Skyhawkson/MIDI-Keyboard/Key Stem Reference Images/README.txt

I used the blue 8MM cherry dimensions, but added .125mm to each dimension for the socket.
