Skyhawkson/MIDI-Keyboard/Board Files/Mainboard.png

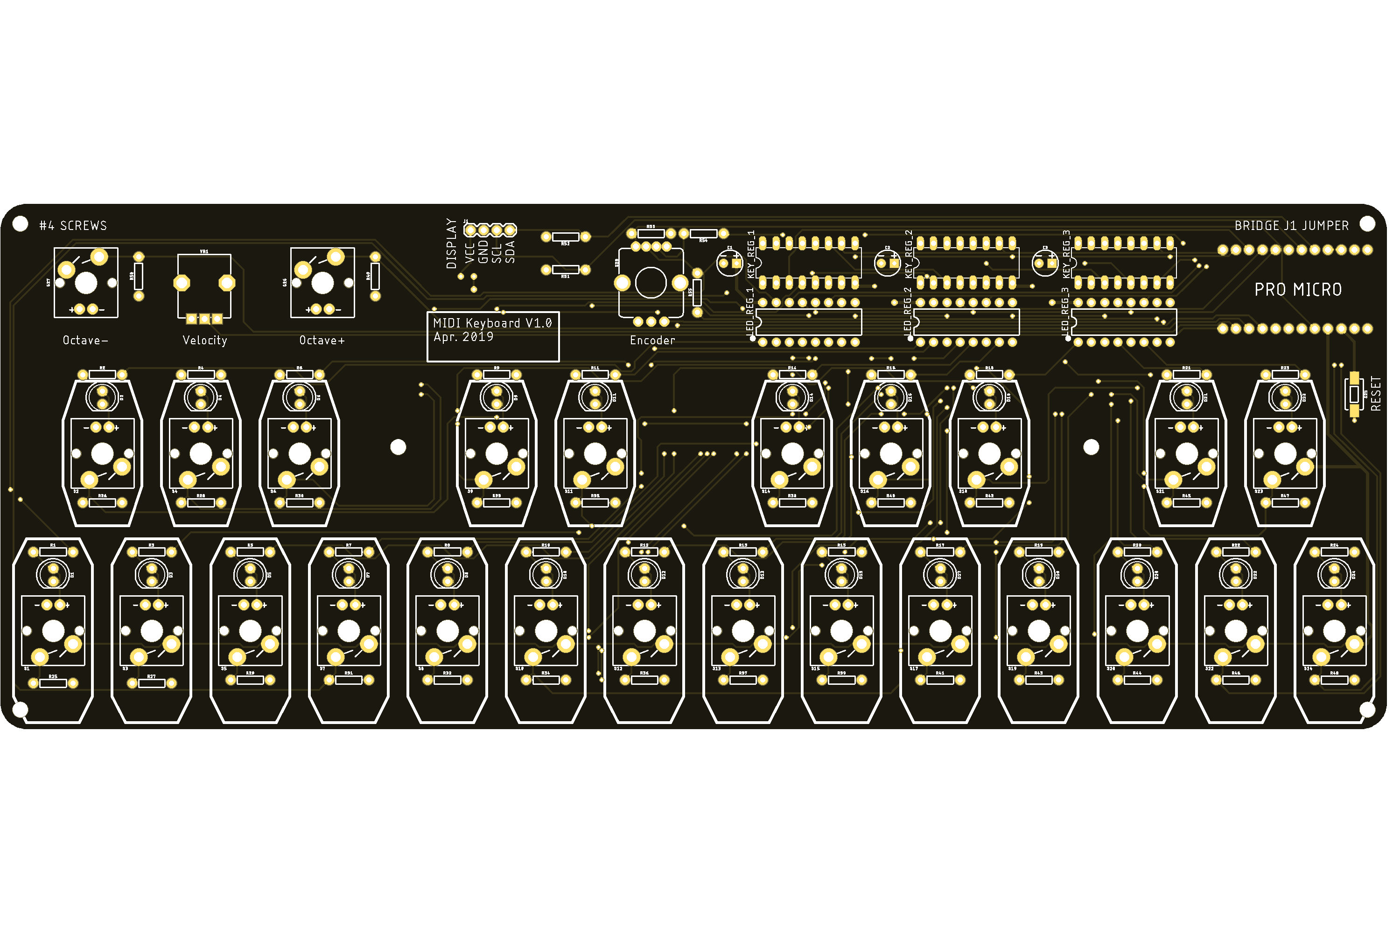
Board Files/Mainboard.png
