Skyhawkson/MIDI-Keyboard/Key Stem Reference Images/kailh-pg151101-cross-stem-specifications.jpg

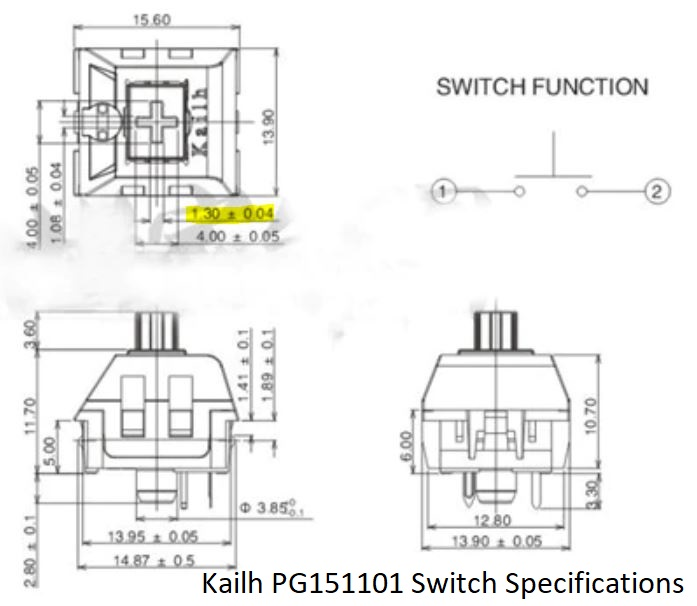
Key Stem Reference Images/kailh-pg151101-cross-stem-specifications.jpg
