Skyhawkson/MIDI-Keyboard/CAD Files/Board_Assembly.SLDASM

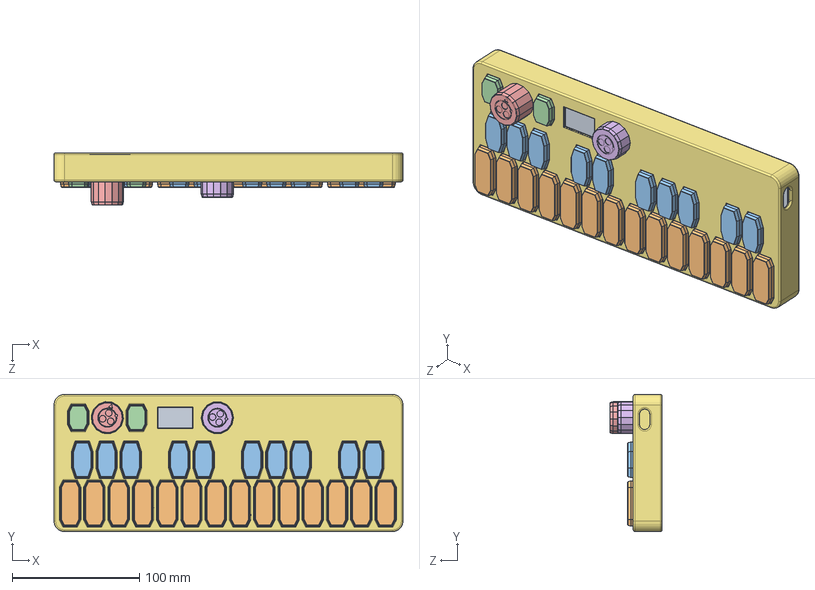
[picture p3: CAD file, 2019-04-23]
CAD Files/Board_Assembly.SLDASM
274.0 x 107.6 x 40.9 mm
White_Key_Flat x 14
Black_Key_Flat x 10
Octave_Key_Flat x 2
Velocity_Dial
Encoder_Dial
Top_Cover
Display
