Skyhawkson/MIDI-Keyboard/CAD Files/Mainboard_PCB.SLDPRT

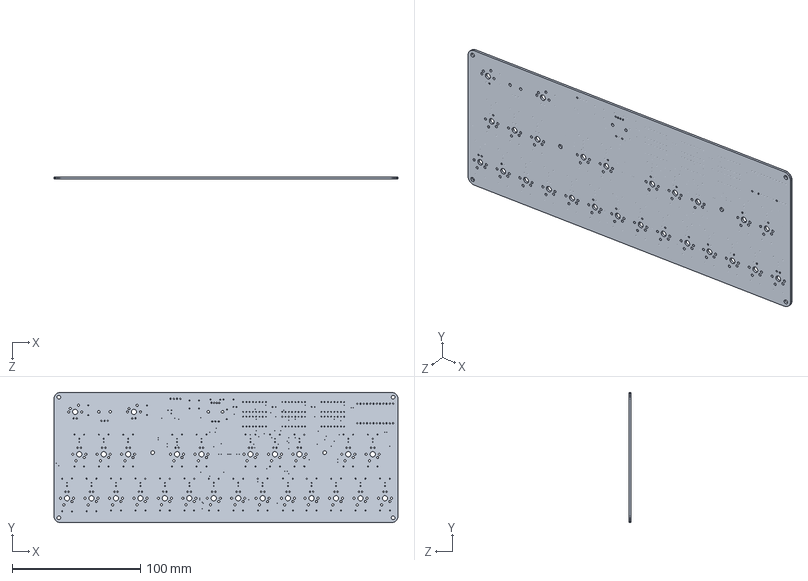
[picture p4: CAD file, 2019-04-22]
CAD Files/Mainboard_PCB.SLDPRT
268.0 x 101.6 x 1.60 mm
