Skyhawkson/MIDI-Keyboard/CAD Files/Top_Cover.SLDPRT

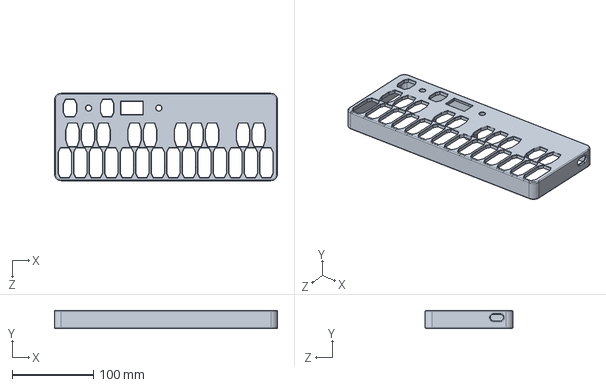
[picture p5: CAD file, 2019-04-23]
CAD Files/Top_Cover.SLDPRT
274.0 x 22.6 x 107.6 mm
