Skyhawkson/MIDI-Keyboard/CAD Files/Display.SLDPRT

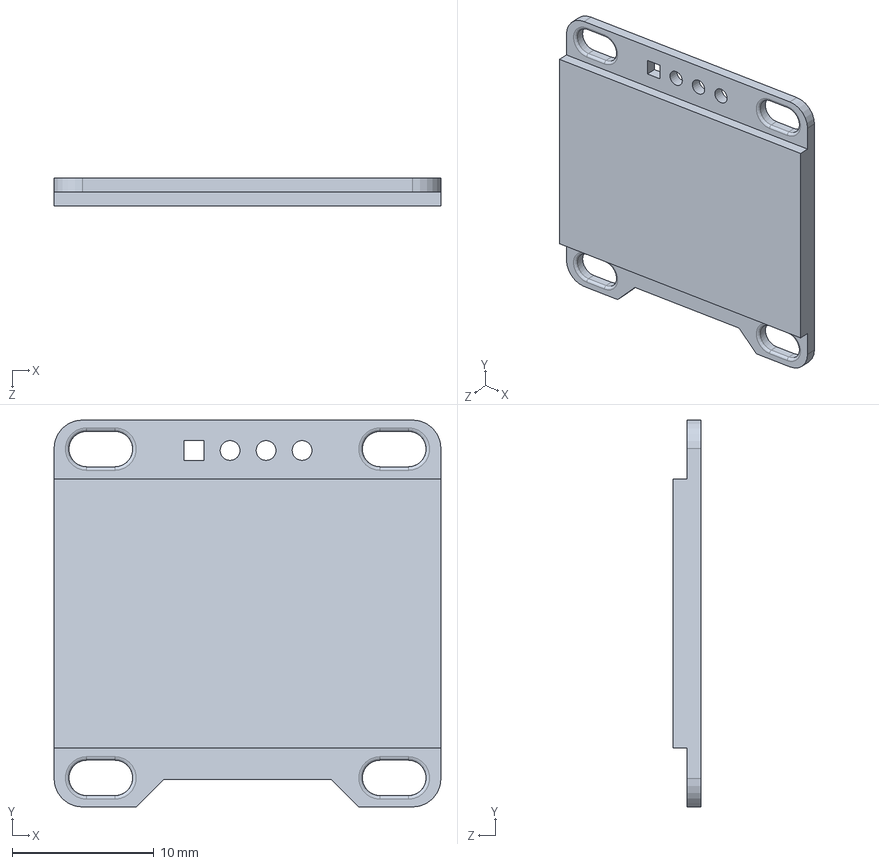
[picture p6: CAD file, 2019-04-23]
CAD Files/Display.SLDPRT
27.3 x 27.3 x 2.00 mm
