Skyhawkson/MIDI-Keyboard/CAD Files/White_Key_Flat.SLDPRT

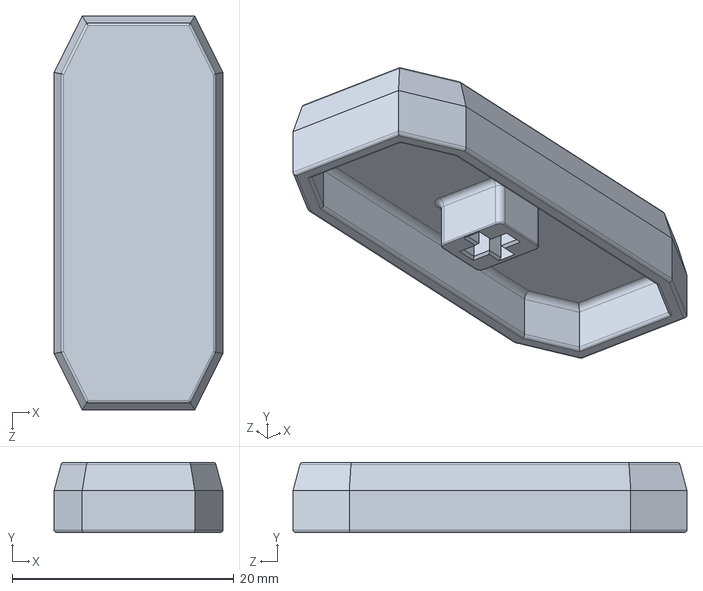
[picture p7: CAD file, 2019-04-23]
CAD Files/White_Key_Flat.SLDPRT
15.2 x 6.34 x 35.6 mm
