Skyhawkson/MIDI-Keyboard/CAD Files/Black_Key_Flat.SLDPRT

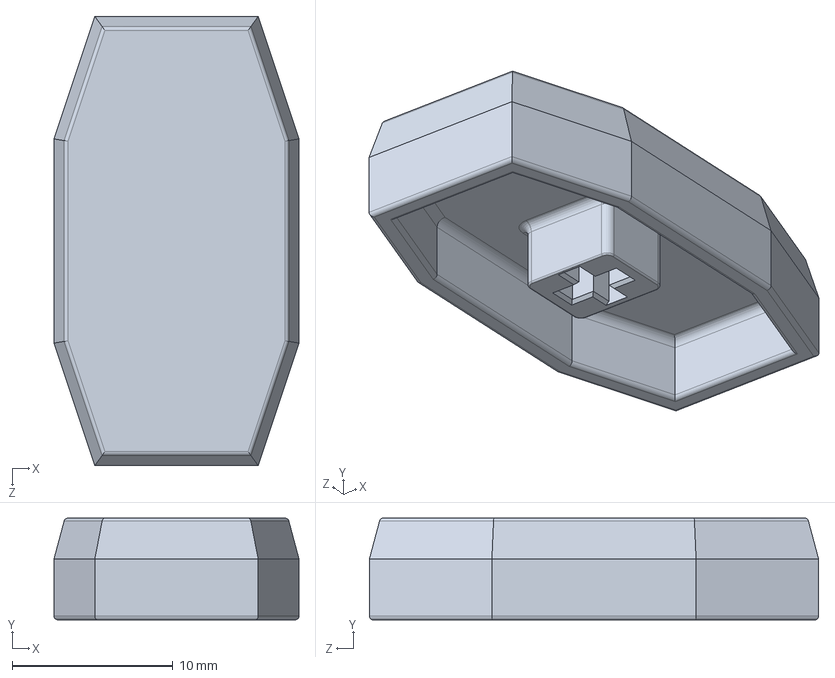
[picture p8: CAD file, 2019-04-23]
CAD Files/Black_Key_Flat.SLDPRT
15.2 x 6.34 x 27.9 mm
