Skyhawkson/MIDI-Keyboard/CAD Files/Bottom_Cover.SLDPRT

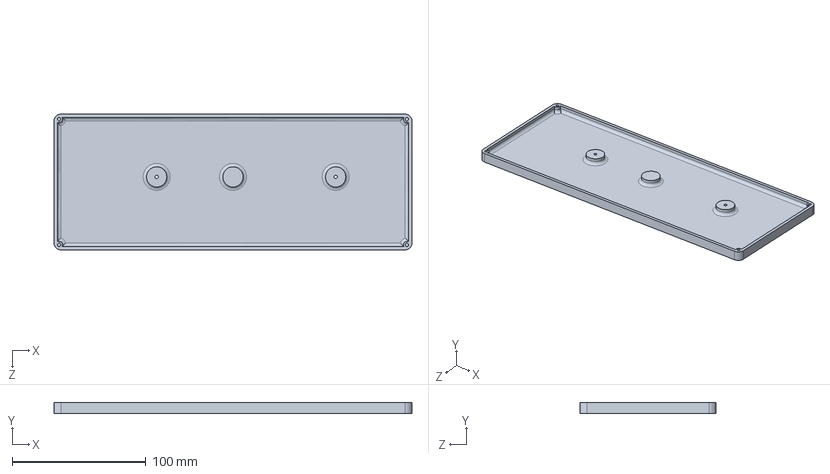
[picture p9: CAD file, 2019-04-23]
CAD Files/Bottom_Cover.SLDPRT
268.0 x 8.00 x 101.6 mm
