Skyhawkson/MIDI-Keyboard/CAD Files/Velocity_Dial.SLDPRT

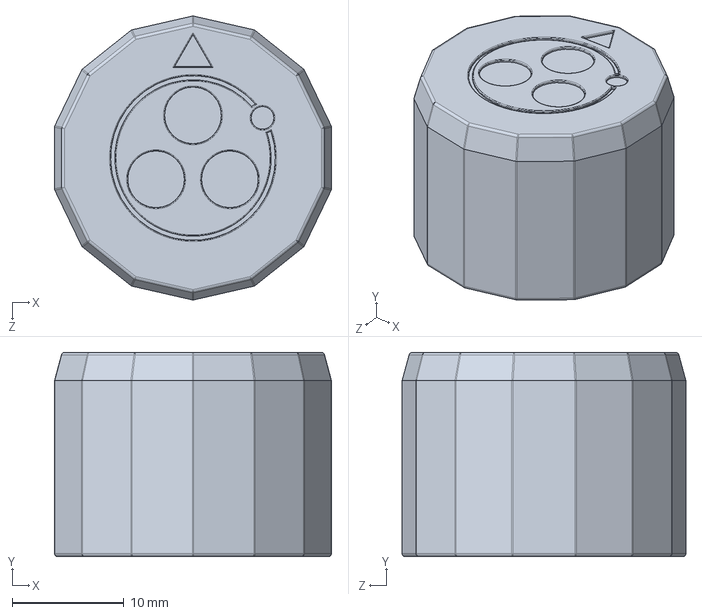
[picture p10: CAD file, 2019-04-23]
CAD Files/Velocity_Dial.SLDPRT
24.8 x 18.3 x 25.4 mm
