Skyhawkson/MIDI-Keyboard/CAD Files/Encoder_Dial.SLDPRT

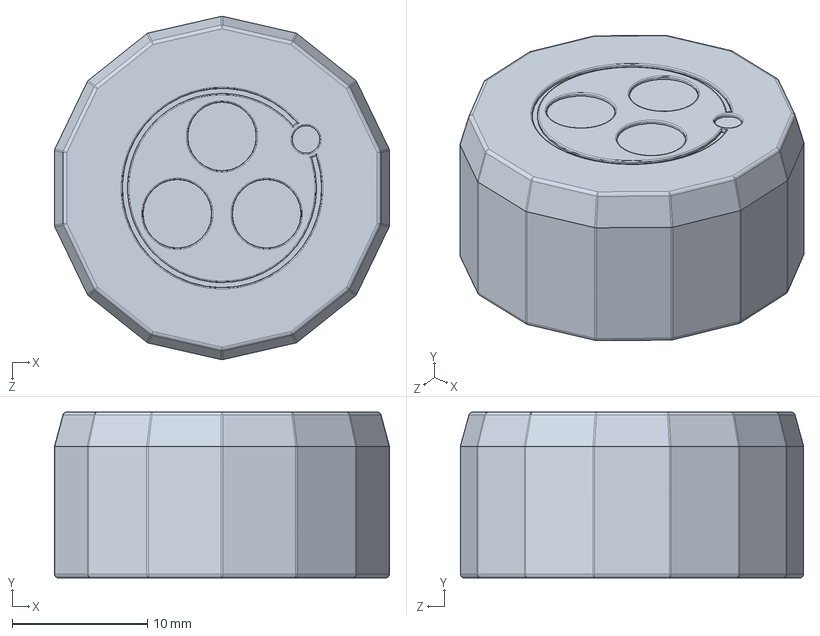
[picture p11: CAD file, 2019-04-23]
CAD Files/Encoder_Dial.SLDPRT
24.8 x 12.3 x 25.4 mm
