Skyhawkson/MIDI-Keyboard/CAD Files/Octave_Key_Flat.SLDPRT

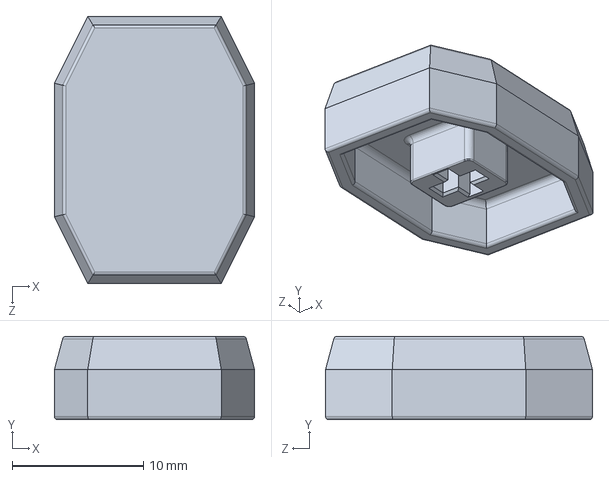
[picture p12: CAD file, 2019-04-23]
CAD Files/Octave_Key_Flat.SLDPRT
15.2 x 6.34 x 20.3 mm
