Skyhawkson/MIDI-Keyboard/(list of files, cad)

Other CAD files:
CAD Files/Encoder_Dial_V1.1.STL
CAD Files/Velocity_Dial_V1.1.STL
CAD Files/Octave_Key_Flat_V1.STL
CAD Files/White_Key_Dished.SLDPRT
CAD Files/Black_Key_Dished.SLDPRT
CAD Files/Black_Key_Flat_V1.STL
CAD Files/White_Key_Flat_V1.STL
CAD Files/Bottom_Cover.STL
CAD Files/Top_Cover.STL
