Skyhawkson/MIDI-Keyboard/(threads)

Thread 1 (2019-04-04):

LED Shift Register Master Reclear

Skyhawkson, 2019-04-04:
Consider assigning a Pro Micro pin to pin 10 of the 595's instead of just pulling them high, in order to allow for clearing of the register?

Skyhawkson, 2019-04-17:
-Nah. Pulling it high.

Closed 2019-04-17.

Thread 2 (2019-04-04):

Common Clock Pin?

Skyhawkson, 2019-04-04:
Determine whether a common clock pin is viable to free up an extra pin.

Skyhawkson, 2019-04-04:
On issue of common pins:
Data: Obviously not
Latch: No, since the LEDs aren't intended to update everytime the buttons aren't being read
Clock: Clock idles low for both, can share, as long as latch isn't common.

Closed 2019-04-04.
