Skyhawkson/MIDI-Keyboard/Board Files/Mainboard.brd

## EAGLE design Board Files/Mainboard.brd (2019-04-23)

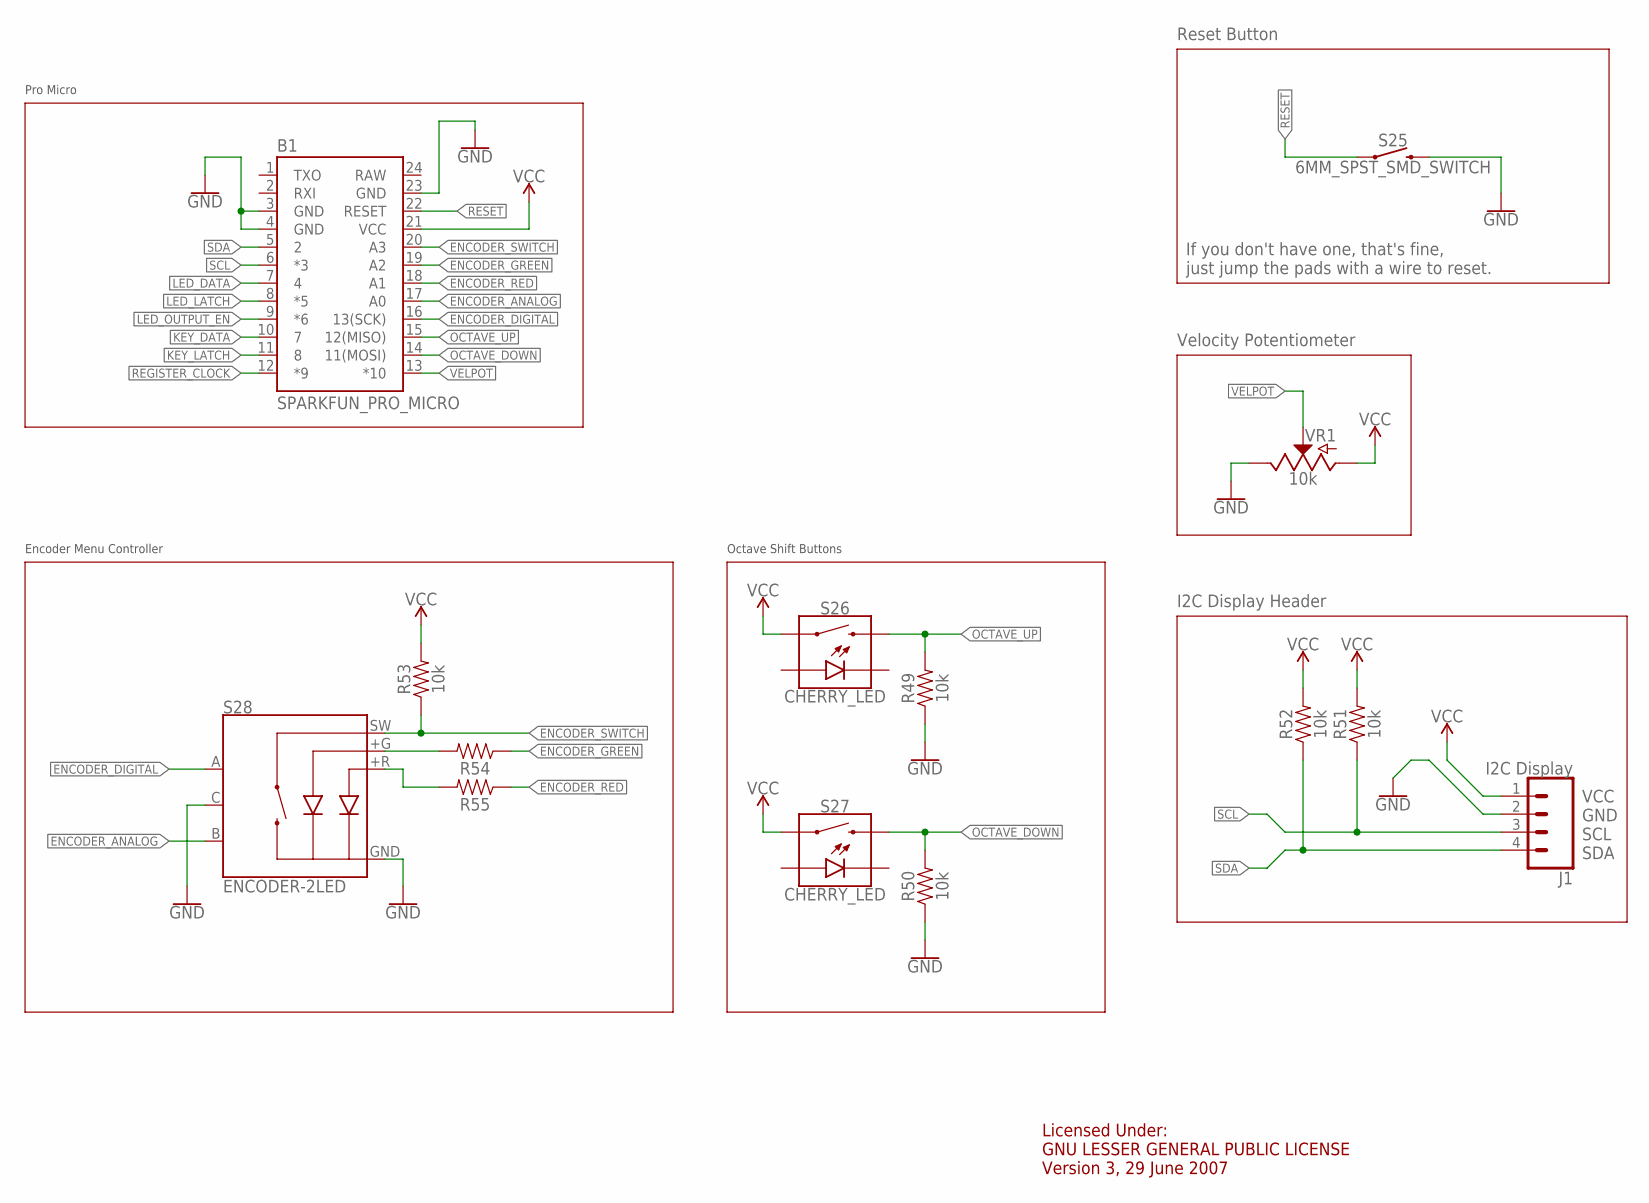
[picture p13: schematic Mainboard.sch, sheet 1, Pro Micro and Misc. IO]

Parts:
B1: SPARKFUN_PRO_MICRO
J1: I2C Display; 1X04
R49, R50, R51, R52, R53: 10k; AXIAL-0.3
R54, R55: AXIAL-0.3
S25: 6MM_SPST_SMD_SWITCH; TACTILE_SWITCH_SMD_6.0X3.5MM
S26, S27: CHERRY_LED; CHERRY-MX-LED
S28: ENCODER-2LED; ENCODER_LED_2
VR1: 10k; POT-PTH-ALPS

Connections:
ENCODER_ANALOG: B1.17 (A0), S28.B
ENCODER_DIGITAL: B1.16 (13(SCK)), S28.A
ENCODER_GREEN: B1.19 (A2), R54.P$1 (1)
ENCODER_RED: B1.18 (A1), R55.P$1 (1)
ENCODER_SWITCH: B1.20 (A3), R53.P$1 (1), S28.SW
GND: B1.3 (GND), B1.4 (GND), B1.23 (GND), J1.2, R49.P$1 (1), R50.P$1 (1), S25.2, S28.C, S28.GND (-), VR1.P$1 (E); also elsewhere on the board
KEY_DATA: B1.10 (7); also elsewhere on the board
KEY_LATCH: B1.11 (8); also elsewhere on the board
LED_DATA: B1.7 (4); also elsewhere on the board
LED_LATCH: B1.8 (*5); also elsewhere on the board
LED_OUTPUT_EN: B1.9 (*6); also elsewhere on the board
unnamed: R54.P$2 (2), S28.+G
unnamed: R55.P$2 (2), S28.+R
OCTAVE_DOWN: B1.14 (11(MOSI)), R50.P$2 (2), S27.S2 (2)
OCTAVE_UP: B1.15 (12(MISO)), R49.P$2 (2), S26.S2 (2)
RAW: B1.24 (RAW)
REGISTER_CLOCK: B1.12 (*9); also elsewhere on the board
RESET: B1.22 (RESET), S25.1
SCL: B1.6 (*3), J1.3, R51.P$1 (1)
SDA: B1.5 (2), J1.4, R52.P$1 (1)
VCC: B1.21 (VCC), J1.1, R51.P$2 (2), R52.P$2 (2), R53.P$2 (2), S26.S1 (1), S27.S1 (1), VR1.P$3 (A); also elsewhere on the board
VELPOT: B1.13 (*10), VR1.P$2 (S)

Notes on the sheet:
Reset Button
Velocity Potentiometer
VCC GND SCL SDA
I2C Display Header
If you don't have one, that's fine, just jump the pads with a wire to reset.
Licensed Under: GNU LESSER GENERAL PUBLIC LICENSE Version 3, 29 June 2007
Octave Shift Buttons
Encoder Menu Controller
Pro Micro

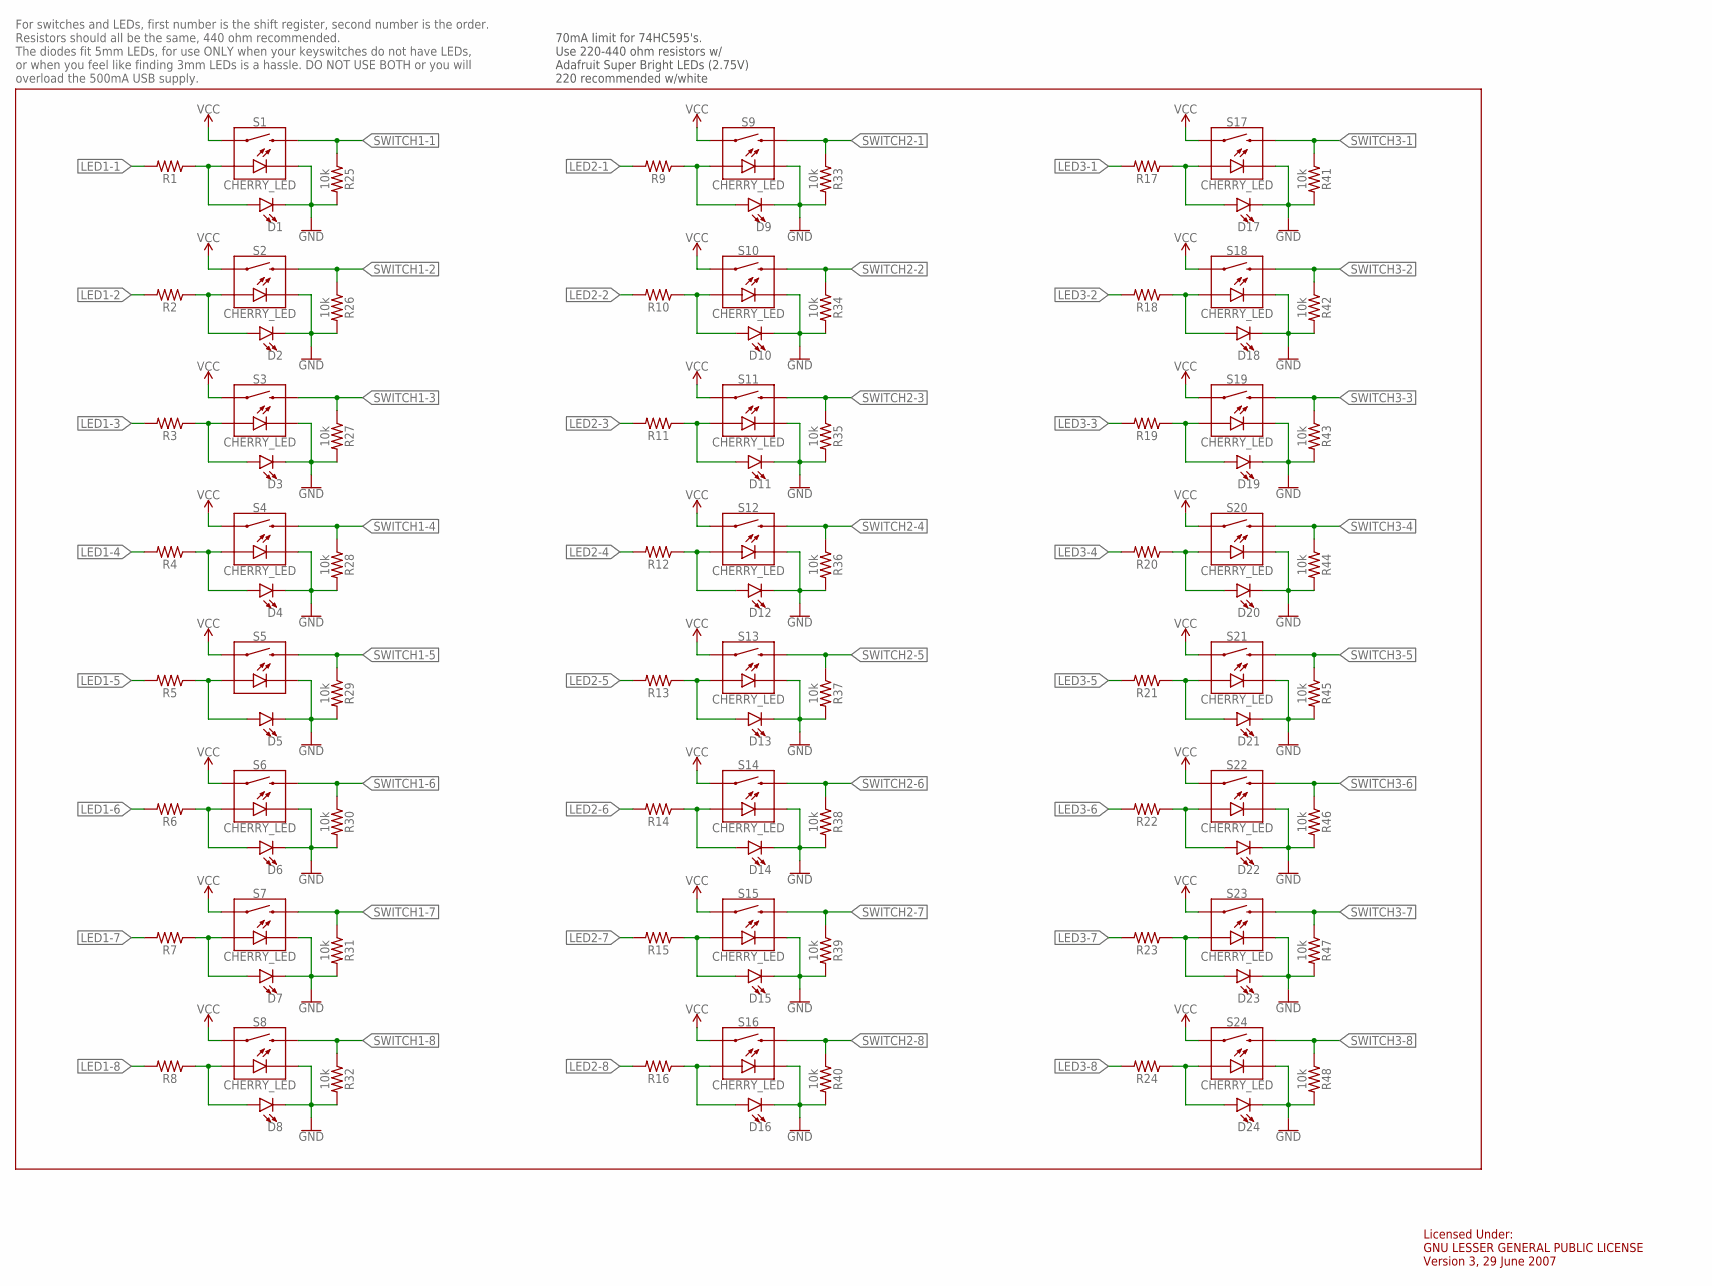
[picture p14: schematic Mainboard.sch, sheet 2, Keyswitches]

Parts:
D1, D2, D3, D4, D5, D6, D7, D8, D9, D10, D11, D12, D13, D14, D15, D16, D17, D18, D19, D20, D21, D22, D23, D24: LED5MM; LED_5MM
R1, R2, R3, R4, R5, R6, R7, R8, R9, R10, R11, R12, R13, R14, R15, R16, R17, R18, R19, R20, R21, R22, R23, R24: AXIAL-0.3
R25, R26, R27, R28, R29, R30, R31, R32, R33, R34, R35, R36, R37, R38, R39, R40, R41, R42, R43, R44, R45, R46, R47, R48: 10k; AXIAL-0.3
S1, S2, S3, S4, S6, S7, S8, S9, S10, S11, S12, S13, S14, S15, S16, S17, S18, S19, S20, S21, S22, S23, S24: CHERRY_LED; CHERRY-MX-LED
S5: MOMENTARY-SWITCH-SPST-LED-PTH-CHERRY; CHERRY-MX-LED

Connections:
GND: D1.K (C), D2.K (C), D3.K (C), D4.K (C), D5.K (C), D6.K (C), D7.K (C), D8.K (C), D9.K (C), D10.K (C), D11.K (C), D12.K (C), D13.K (C), D14.K (C), D15.K (C), D16.K (C), D17.K (C), D18.K (C), D19.K (C), D20.K (C), D21.K (C), D22.K (C), D23.K (C), D24.K (C), R25.P$2 (2), R26.P$2 (2), R27.P$2 (2), R28.P$2 (2), R29.P$2 (2), R30.P$2 (2), R31.P$2 (2), R32.P$2 (2), R33.P$2 (2), R34.P$2 (2), R35.P$2 (2), R36.P$2 (2), R37.P$2 (2), R38.P$2 (2), R39.P$2 (2), R40.P$2 (2), R41.P$2 (2), R42.P$2 (2), R43.P$2 (2), R44.P$2 (2), R45.P$2 (2), R46.P$2 (2), R47.P$2 (2), R48.P$2 (2), S1.K (C), S2.K (C), S3.K (C), S4.K (C), S5.K (C), S6.K (C), S7.K (C), S8.K (C), S9.K (C), S10.K (C), S11.K (C), S12.K (C), S13.K (C), S14.K (C), S15.K (C), S16.K (C), S17.K (C), S18.K (C), S19.K (C), S20.K (C), S21.K (C), S22.K (C), S23.K (C), S24.K (C); also elsewhere on the board
LED1-1: R1.P$2 (2); also elsewhere on the board
LED1-2: R2.P$2 (2); also elsewhere on the board
LED1-3: R3.P$2 (2); also elsewhere on the board
LED1-4: R4.P$2 (2); also elsewhere on the board
LED1-5: R5.P$2 (2); also elsewhere on the board
LED1-6: R6.P$2 (2); also elsewhere on the board
LED1-7: R7.P$2 (2); also elsewhere on the board
LED1-8: R8.P$2 (2); also elsewhere on the board
LED2-1: R9.P$2 (2); also elsewhere on the board
LED2-2: R10.P$2 (2); also elsewhere on the board
LED2-3: R11.P$2 (2); also elsewhere on the board
LED2-4: R12.P$2 (2); also elsewhere on the board
LED2-5: R13.P$2 (2); also elsewhere on the board
LED2-6: R14.P$2 (2); also elsewhere on the board
LED2-7: R15.P$2 (2); also elsewhere on the board
LED2-8: R16.P$2 (2); also elsewhere on the board
LED3-1: R17.P$2 (2); also elsewhere on the board
LED3-2: R18.P$2 (2); also elsewhere on the board
LED3-3: R19.P$2 (2); also elsewhere on the board
LED3-4: R20.P$2 (2); also elsewhere on the board
LED3-5: R21.P$2 (2); also elsewhere on the board
LED3-6: R22.P$2 (2); also elsewhere on the board
LED3-7: R23.P$2 (2); also elsewhere on the board
LED3-8: R24.P$2 (2); also elsewhere on the board
unnamed: D1.A, R1.P$1 (1), S1.A
unnamed: D2.A, R2.P$1 (1), S2.A
unnamed: D3.A, R3.P$1 (1), S3.A
unnamed: D4.A, R4.P$1 (1), S4.A
unnamed: D5.A, R5.P$1 (1), S5.A
unnamed: D6.A, R6.P$1 (1), S6.A
unnamed: D7.A, R7.P$1 (1), S7.A
unnamed: D8.A, R8.P$1 (1), S8.A
unnamed: D9.A, R9.P$1 (1), S9.A
unnamed: D10.A, R10.P$1 (1), S10.A
unnamed: D11.A, R11.P$1 (1), S11.A
unnamed: D12.A, R12.P$1 (1), S12.A
unnamed: D13.A, R13.P$1 (1), S13.A
unnamed: D14.A, R14.P$1 (1), S14.A
unnamed: D15.A, R15.P$1 (1), S15.A
unnamed: D16.A, R16.P$1 (1), S16.A
unnamed: D17.A, R17.P$1 (1), S17.A
unnamed: D18.A, R18.P$1 (1), S18.A
unnamed: D19.A, R19.P$1 (1), S19.A
unnamed: D20.A, R20.P$1 (1), S20.A
unnamed: D21.A, R21.P$1 (1), S21.A
unnamed: D22.A, R22.P$1 (1), S22.A
unnamed: D23.A, R23.P$1 (1), S23.A
unnamed: D24.A, R24.P$1 (1), S24.A
SWITCH1-1: R25.P$1 (1), S1.S2 (2); also elsewhere on the board
SWITCH1-2: R26.P$1 (1), S2.S2 (2); also elsewhere on the board
SWITCH1-3: R27.P$1 (1), S3.S2 (2); also elsewhere on the board
SWITCH1-4: R28.P$1 (1), S4.S2 (2); also elsewhere on the board
SWITCH1-5: R29.P$1 (1), S5.S2 (2); also elsewhere on the board
SWITCH1-6: R30.P$1 (1), S6.S2 (2); also elsewhere on the board
SWITCH1-7: R31.P$1 (1), S7.S2 (2); also elsewhere on the board
SWITCH1-8: R32.P$1 (1), S8.S2 (2); also elsewhere on the board
SWITCH2-1: R33.P$1 (1), S9.S2 (2); also elsewhere on the board
SWITCH2-2: R34.P$1 (1), S10.S2 (2); also elsewhere on the board
SWITCH2-3: R35.P$1 (1), S11.S2 (2); also elsewhere on the board
SWITCH2-4: R36.P$1 (1), S12.S2 (2); also elsewhere on the board
SWITCH2-5: R37.P$1 (1), S13.S2 (2); also elsewhere on the board
SWITCH2-6: R38.P$1 (1), S14.S2 (2); also elsewhere on the board
SWITCH2-7: R39.P$1 (1), S15.S2 (2); also elsewhere on the board
SWITCH2-8: R40.P$1 (1), S16.S2 (2); also elsewhere on the board
SWITCH3-1: R41.P$1 (1), S17.S2 (2); also elsewhere on the board
SWITCH3-2: R42.P$1 (1), S18.S2 (2); also elsewhere on the board
SWITCH3-3: R43.P$1 (1), S19.S2 (2); also elsewhere on the board
SWITCH3-4: R44.P$1 (1), S20.S2 (2); also elsewhere on the board
SWITCH3-5: R45.P$1 (1), S21.S2 (2); also elsewhere on the board
SWITCH3-6: R46.P$1 (1), S22.S2 (2); also elsewhere on the board
SWITCH3-7: R47.P$1 (1), S23.S2 (2); also elsewhere on the board
SWITCH3-8: R48.P$1 (1), S24.S2 (2); also elsewhere on the board
VCC: S1.S1 (1), S2.S1 (1), S3.S1 (1), S4.S1 (1), S5.S1 (1), S6.S1 (1), S7.S1 (1), S8.S1 (1), S9.S1 (1), S10.S1 (1), S11.S1 (1), S12.S1 (1), S13.S1 (1), S14.S1 (1), S15.S1 (1), S16.S1 (1), S17.S1 (1), S18.S1 (1), S19.S1 (1), S20.S1 (1), S21.S1 (1), S22.S1 (1), S23.S1 (1), S24.S1 (1); also elsewhere on the board

Notes on the sheet:
For switches and LEDs, first number is the shift register, second number is the order. Resistors should all be the same, 440 ohm recommended. The diodes fit 5mm LEDs, for use ONLY when your keyswitches do not have LEDs, or when you feel like finding 3mm LEDs is a hassle. DO NOT USE BOTH or you will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
70mA limit for 74HC595's. Use 220-440 ohm resistors w/ Adafruit Super Bright LEDs (2.75V) 220 recommended w/white
Licensed Under: GNU LESSER GENERAL PUBLIC LICENSE Version 3, 29 June 2007

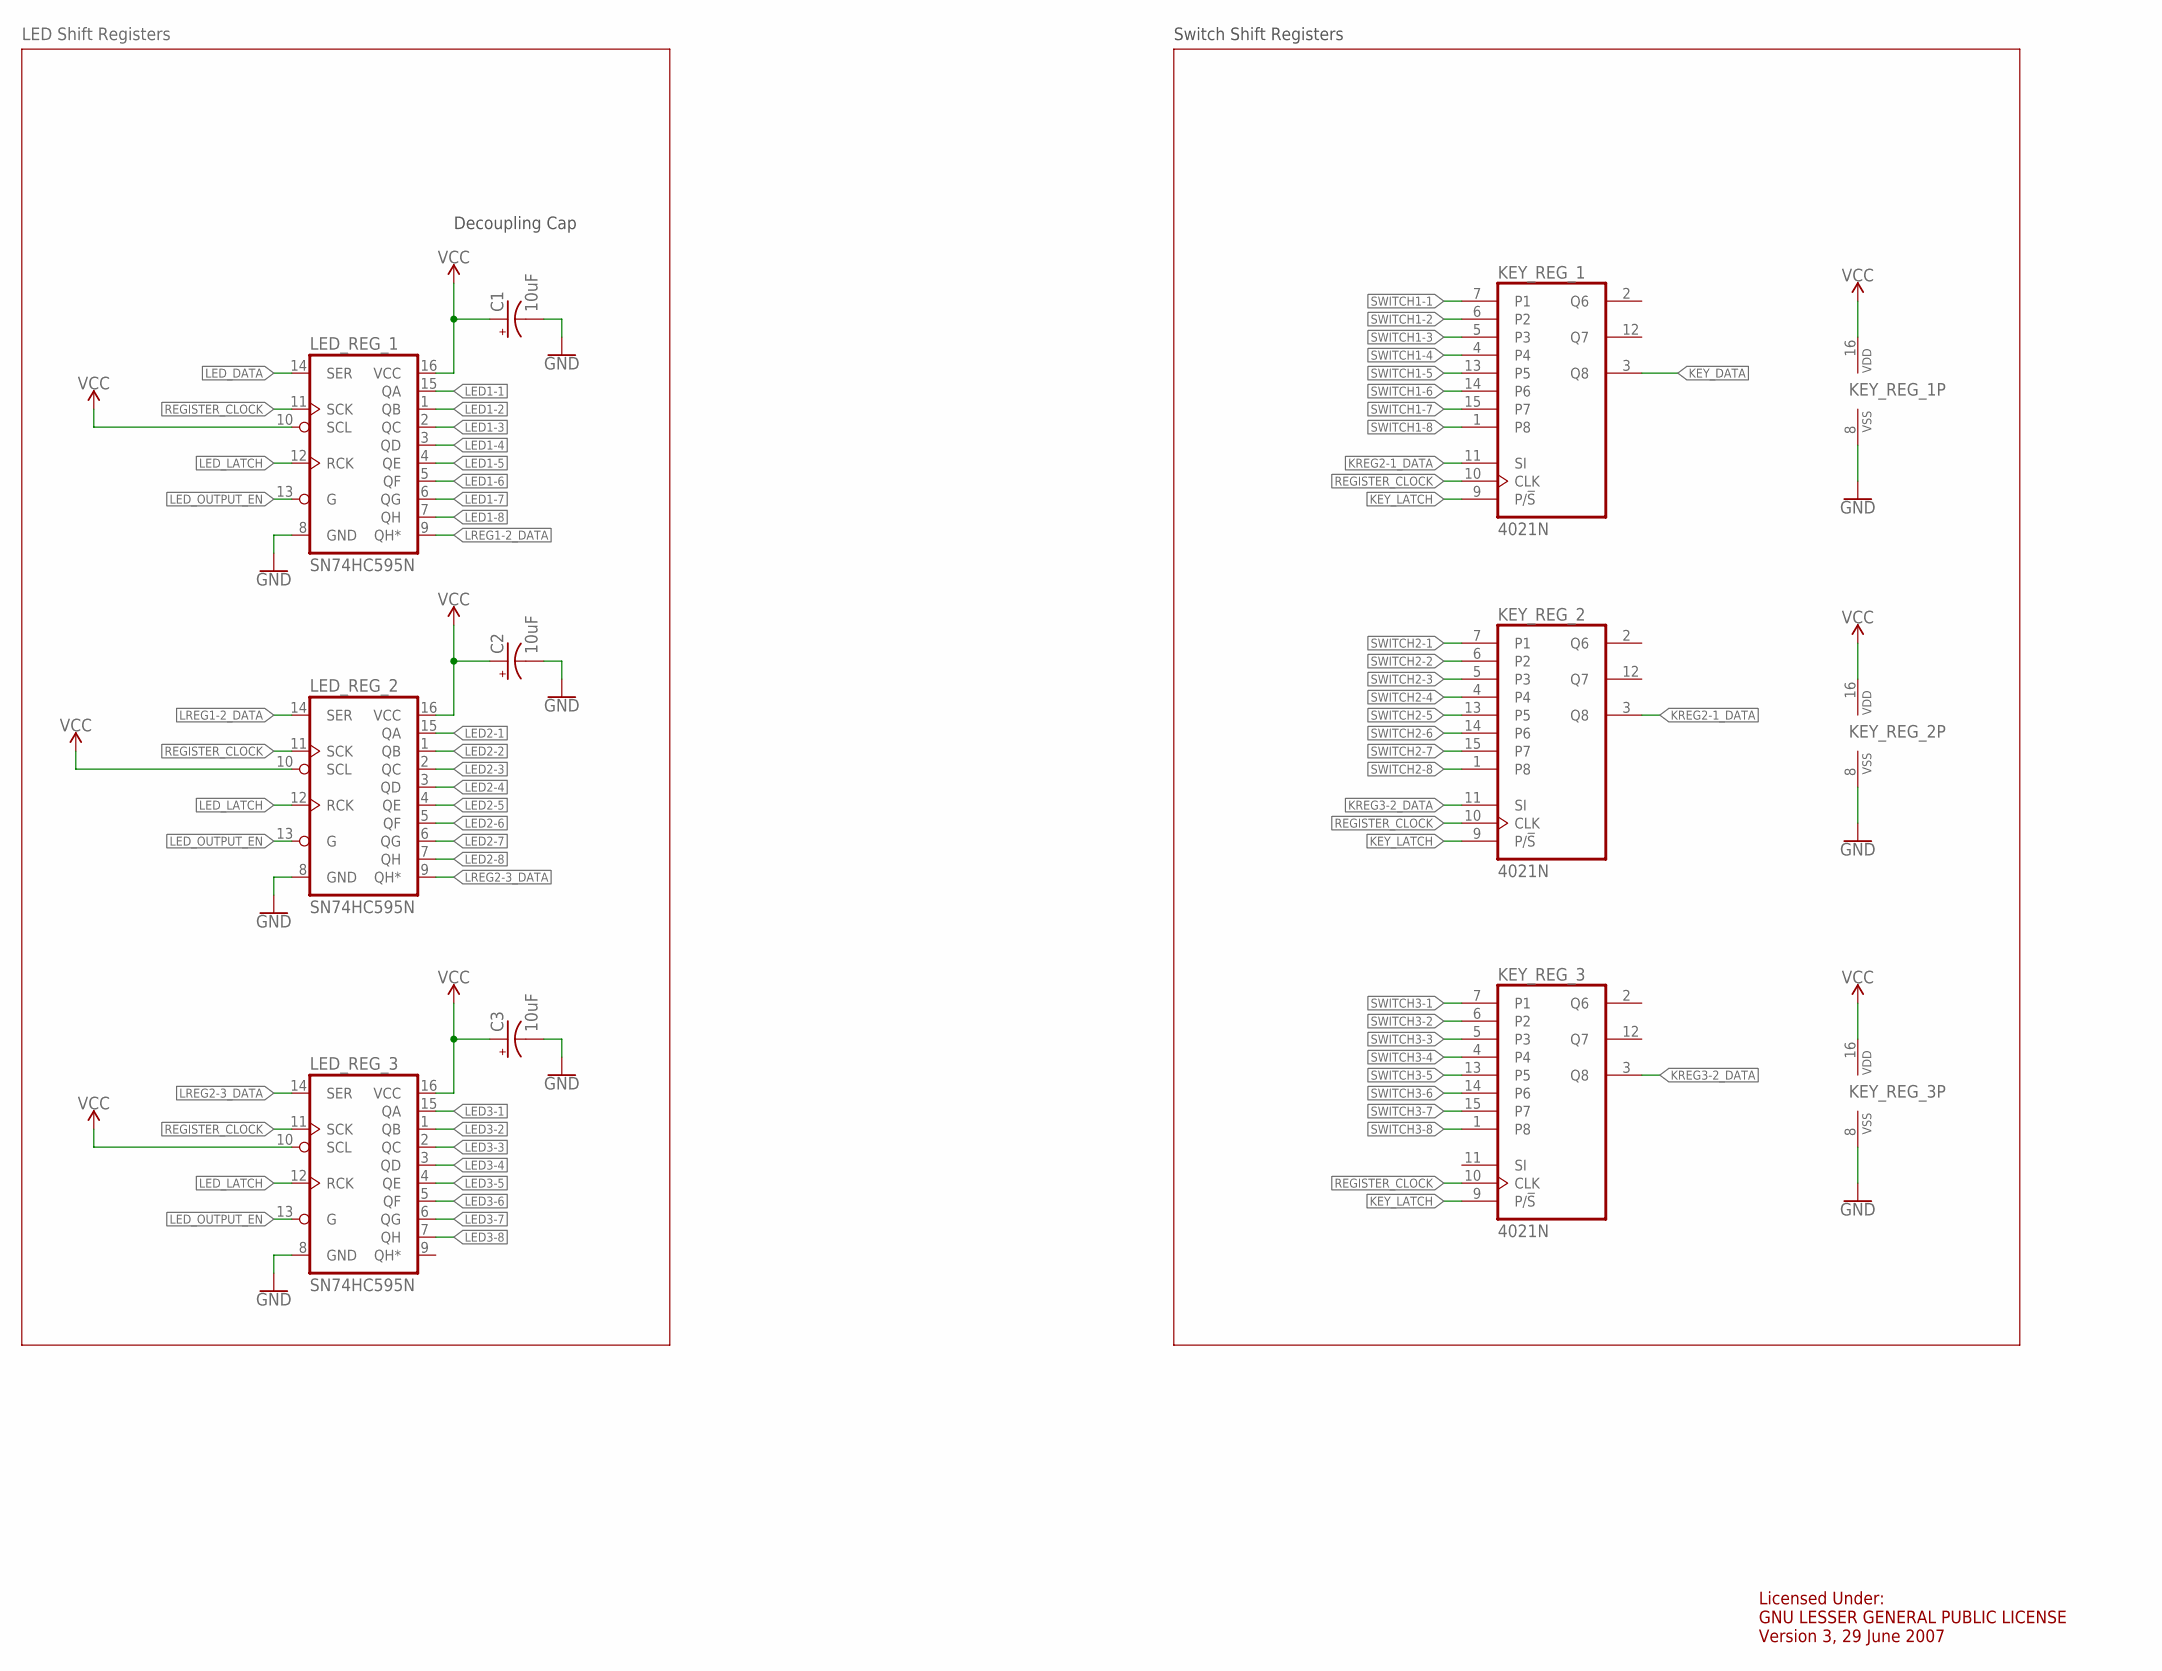
[picture p15: schematic Mainboard.sch, sheet 3, Shift Registers]

Parts:
C1, C2, C3: 10uF; CPOL-RADIAL-2.5MM-5MM
KEY_REG_1, KEY_REG_2, KEY_REG_3: 4021N; DIL16
LED_REG_1, LED_REG_2, LED_REG_3: SN74HC595N; DIP16

Connections:
GND: C1.2 (-), C2.2 (-), C3.2 (-), KEY_REG_1.8 (VSS), KEY_REG_2.8 (VSS), KEY_REG_3.8 (VSS), LED_REG_1.8 (GND), LED_REG_2.8 (GND), LED_REG_3.8 (GND); also elsewhere on the board
KEY_DATA: KEY_REG_1.3 (Q8); also elsewhere on the board
KEY_LATCH: KEY_REG_1.9 (P/!S), KEY_REG_2.9 (P/!S), KEY_REG_3.9 (P/!S); also elsewhere on the board
KREG2-1_DATA: KEY_REG_1.11 (SI), KEY_REG_2.3 (Q8)
KREG3-2_DATA: KEY_REG_2.11 (SI), KEY_REG_3.3 (Q8)
LED1-1: LED_REG_1.15 (QA); also elsewhere on the board
LED1-2: LED_REG_1.1 (QB); also elsewhere on the board
LED1-3: LED_REG_1.2 (QC); also elsewhere on the board
LED1-4: LED_REG_1.3 (QD); also elsewhere on the board
LED1-5: LED_REG_1.4 (QE); also elsewhere on the board
LED1-6: LED_REG_1.5 (QF); also elsewhere on the board
LED1-7: LED_REG_1.6 (QG); also elsewhere on the board
LED1-8: LED_REG_1.7 (QH); also elsewhere on the board
LED2-1: LED_REG_2.15 (QA); also elsewhere on the board
LED2-2: LED_REG_2.1 (QB); also elsewhere on the board
LED2-3: LED_REG_2.2 (QC); also elsewhere on the board
LED2-4: LED_REG_2.3 (QD); also elsewhere on the board
LED2-5: LED_REG_2.4 (QE); also elsewhere on the board
LED2-6: LED_REG_2.5 (QF); also elsewhere on the board
LED2-7: LED_REG_2.6 (QG); also elsewhere on the board
LED2-8: LED_REG_2.7 (QH); also elsewhere on the board
LED3-1: LED_REG_3.15 (QA); also elsewhere on the board
LED3-2: LED_REG_3.1 (QB); also elsewhere on the board
LED3-3: LED_REG_3.2 (QC); also elsewhere on the board
LED3-4: LED_REG_3.3 (QD); also elsewhere on the board
LED3-5: LED_REG_3.4 (QE); also elsewhere on the board
LED3-6: LED_REG_3.5 (QF); also elsewhere on the board
LED3-7: LED_REG_3.6 (QG); also elsewhere on the board
LED3-8: LED_REG_3.7 (QH); also elsewhere on the board
LED_DATA: LED_REG_1.14 (SER); also elsewhere on the board
LED_LATCH: LED_REG_1.12 (RCK), LED_REG_2.12 (RCK), LED_REG_3.12 (RCK); also elsewhere on the board
LED_OUTPUT_EN: LED_REG_1.13 (G), LED_REG_2.13 (G), LED_REG_3.13 (G); also elsewhere on the board
LREG1-2_DATA: LED_REG_1.9 (QH*), LED_REG_2.14 (SER)
LREG2-3_DATA: LED_REG_2.9 (QH*), LED_REG_3.14 (SER)
REGISTER_CLOCK: KEY_REG_1.10 (CLK), KEY_REG_2.10 (CLK), KEY_REG_3.10 (CLK), LED_REG_1.11 (SCK), LED_REG_2.11 (SCK), LED_REG_3.11 (SCK); also elsewhere on the board
SWITCH1-1: KEY_REG_1.7 (P1); also elsewhere on the board
SWITCH1-2: KEY_REG_1.6 (P2); also elsewhere on the board
SWITCH1-3: KEY_REG_1.5 (P3); also elsewhere on the board
SWITCH1-4: KEY_REG_1.4; also elsewhere on the board
SWITCH1-5: KEY_REG_1.13 (P5); also elsewhere on the board
SWITCH1-6: KEY_REG_1.14 (P6); also elsewhere on the board
SWITCH1-7: KEY_REG_1.15 (P7); also elsewhere on the board
SWITCH1-8: KEY_REG_1.1 (P8); also elsewhere on the board
SWITCH2-1: KEY_REG_2.7 (P1); also elsewhere on the board
SWITCH2-2: KEY_REG_2.6 (P2); also elsewhere on the board
SWITCH2-3: KEY_REG_2.5 (P3); also elsewhere on the board
SWITCH2-4: KEY_REG_2.4; also elsewhere on the board
SWITCH2-5: KEY_REG_2.13 (P5); also elsewhere on the board
SWITCH2-6: KEY_REG_2.14 (P6); also elsewhere on the board
SWITCH2-7: KEY_REG_2.15 (P7); also elsewhere on the board
SWITCH2-8: KEY_REG_2.1 (P8); also elsewhere on the board
SWITCH3-1: KEY_REG_3.7 (P1); also elsewhere on the board
SWITCH3-2: KEY_REG_3.6 (P2); also elsewhere on the board
SWITCH3-3: KEY_REG_3.5 (P3); also elsewhere on the board
SWITCH3-4: KEY_REG_3.4; also elsewhere on the board
SWITCH3-5: KEY_REG_3.13 (P5); also elsewhere on the board
SWITCH3-6: KEY_REG_3.14 (P6); also elsewhere on the board
SWITCH3-7: KEY_REG_3.15 (P7); also elsewhere on the board
SWITCH3-8: KEY_REG_3.1 (P8); also elsewhere on the board
VCC: C1.1 (+), C2.1 (+), C3.1 (+), KEY_REG_1.16 (VDD), KEY_REG_2.16 (VDD), KEY_REG_3.16 (VDD), LED_REG_1.10 (SCL), LED_REG_1.16 (VCC), LED_REG_2.10 (SCL), LED_REG_2.16 (VCC), LED_REG_3.10 (SCL), LED_REG_3.16 (VCC); also elsewhere on the board

Notes on the sheet:
Decoupling Cap
LED Shift Registers
Switch Shift Registers
Licensed Under: GNU LESSER GENERAL PUBLIC LICENSE Version 3, 29 June 2007

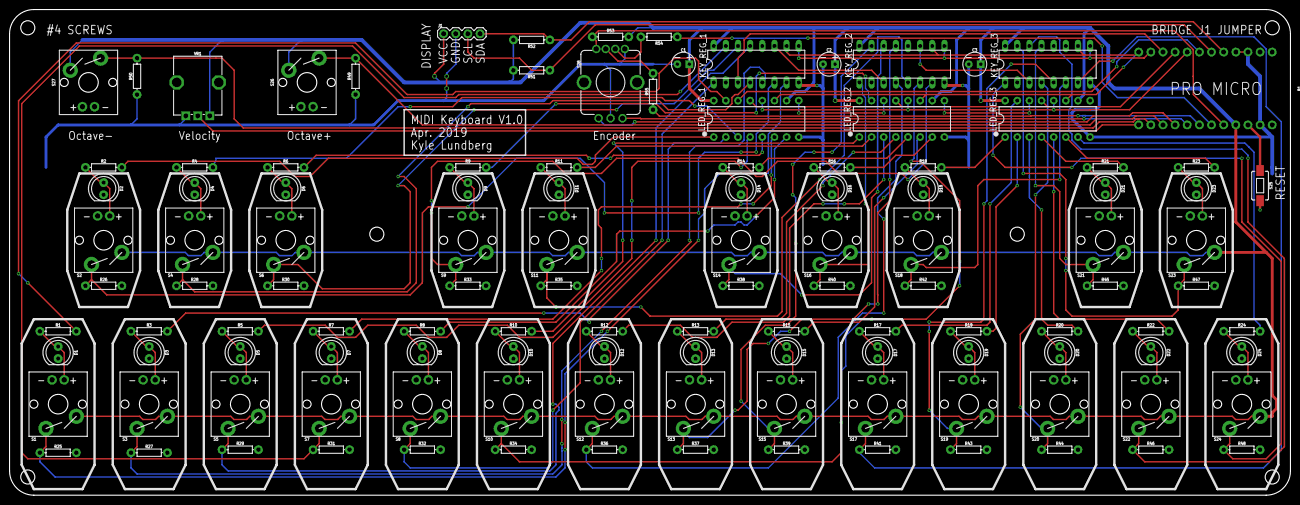
[picture p16: board Mainboard.brd from above]

Board: 2 copper layers, 268.0 x 101.6 mm, 119 parts (0 on the bottom side), 97 nets.
