Skyhawkson/MIDI-Keyboard/(commit log)

2019-04-01 Added libraries
    Added Cherry MX and Pro Micro Footprint libraries
2019-04-01 First Eagle Files
    Added Cherry switches, 5MM LEDs, and resistors to schematic.
    [Mainboard.sch]
2019-04-01 Switched to Sparkfun libraries
    Removed pro micro footprint in lieu of official sparkfun footprint. Added in the LED-controlling shift registers.
2019-04-03 Board Updates
    -Reset Switch
    -Velocity Pot
    -Frames
    -Started connecting shift registers
    [Mainboard.sch]
2019-04-04 Finished Shift Registers
    -Finished pins on 595s
    -Added and completed pins on 4021B's
    -Added 10k resistors to switch side
    -Added issues to test and consider to github
    [Mainboard.sch]
2019-04-04 Completed First Schematic Draft
    -Switched to Sparkfun Cherry parts
    -Added illuminated rotary encoder
    -Connected all microcontroller pins
    -Finished shift register pins
    -Added octave shift buttons
    [Mainboard.sch]
2019-04-04 Beginning Board Work
    Tentative board dimensions and layout
    [Mainboard.brd, Mainboard.sch]
2019-04-05 Board Layout Update
    -Routed VCC and GND to white keys
    -Routed GND to black keys
    -Placed most components on board
    [Mainboard.brd, Mainboard.sch]
2019-04-05 Preliminary Keycap CAD
    -Modeled a test flat white key cap
    -Added references used to create stem socket dimensions
    [White_Key_Dished.SLDPRT, White_Key_Flat.SLDPRT, White_Key_Flat_STL.STL]
2019-04-07 Added Key .STL files
    -Added white and black key .STLs
    -Consolidated Arduino folder
    [Black_Key_Flat.SLDPRT, Black_Key_Flat_STL.STL]
2019-04-07 Routed LEDs and most switches
    -Routed all LEDs
    -Routes 2/3rds of switches
    -Probably need to reroute the right side
    [Mainboard.brd, Mainboard.sch]
2019-04-08 Board Updates, Keycap Updates, Trimmed Libraries
    -Finished routing switch and LED traces, will need cleanup
    -Made dished versions of keycaps. Thickened top and bottom walls of key stems
    -Removed extraneous cherry libraries; fully using Sparkfun and native Eagle ones now
    [Black_Key_Dished.SLDPRT, Black_Key_Flat.SLDPRT, Mainboard.brd, White_Key_Dished.SLDPRT, White_Key_Flat.SLDPRT]
2019-04-10 Began New PCB
    -Deleted cramped PCB, started new layout.
    [Mainboard.brd]
2019-04-14 Updated BRD and SCH
    -Added more smoothing caps to schematic, placed things, reverted to old STL files
    [Black_Key_Flat.STL, Black_Key_Flat_STL.STL, Mainboard.brd, Mainboard.sch, White_Key_Flat.STL, White_Key_Flat_STL.STL]
2019-04-14 Finished Manual Routing
    Finished routing manual traces. Will autoroute the switch and LED traces
    [Mainboard.brd, Mainboard.sch]
2019-04-15 Preliminary Finished Layout
    WIth help of autorouter and hand finishing, completed an initial PCB layout
    [Mainboard.brd, Mainboard.sch]
2019-04-15 Added Dial .STLs and Proven Key STLs
    -Added Octave Keys
    -Added Encoder Dial
    -Added Velocity Dial
    -Uploaded old, proven white/black key .STLs
    [Black_Key_Flat.STL, Black_Key_Flat_V1.STL, Encoder_Dial.SLDPRT, Encoder_Dial_V1.STL, Octave_Key_Flat.SLDPRT, Octave_Key_Flat_V1.STL, Velocity_Dial.SLDPRT, Velocity_Dial_V1.STL]
2019-04-17 Updated STLs and Removed Thermal Checking
    -Updated Encoder Dial to V1.1
    -Updated Velocity Dial to V1.1
    -Changed diameter from 6.25mm to 6.125mm on both
    -Removed thermal checks on board DRC
    [Encoder_Dial.SLDPRT, Encoder_Dial_V1.1.STL, Encoder_Dial_V1.STL, Mainboard.brd, Velocity_Dial.SLDPRT, Velocity_Dial_V1.1.STL, Velocity_Dial_V1.STL]
2019-04-17 Further Trimmed Dial Diameter
    -Moved shaft diameter to nominal 6mm, since measured parts were ~5.95mm stem diameter
    [Encoder_Dial.SLDPRT, Encoder_Dial_V1.1.STL, Velocity_Dial.SLDPRT, Velocity_Dial_V1.1.STL]
2019-04-17 Cleaned up more routing
    -Still need to do physical layout check
    [Mainboard.brd]
2019-04-18 Finished Mainboard V1.0
    -Added holes
    -Labeled everything
    -Final trace cleanup
    [Mainboard.brd, Mainboard.sch]
2019-04-18 Casing Completed. Except Screen
    -Completed base housing
    -Need to add OLED screen
    [Black_Key_Flat.SLDPRT, Board_Assembly.SLDASM, Bottom_Cover.SLDPRT, Mainboard_PCB.SLDPRT, Top_Cover.SLDPRT]
2019-04-22 Added Top and Bottom Cover STLs
    [Bottom_Cover.STL, Top_Cover.STL]
2019-04-22 Updated Parts and Assembly
    [Black_Key_Flat.SLDPRT, Board_Assembly.SLDASM, Bottom_Cover.SLDPRT, Bottom_Cover.STL, Encoder_Dial.SLDPRT, Mainboard_PCB.SLDPRT, Octave_Key_Flat.SLDPRT, Top_Cover.SLDPRT]
2019-04-23 Updated Assembly and Board Tweaks
    -Added color to parts in assembly, made renders
    -Did final layout adjustments on mainboard. Renamed resistors
    [Black_Key_Flat.SLDPRT, Board_Assembly.SLDASM, Bottom_Cover.SLDPRT, Encoder_Dial.SLDPRT, Mainboard.brd, Mainboard.sch, Octave_Key_Flat.SLDPRT, Top_Cover.SLDPRT]
2019-04-23 Finished Mainboard and Assembly
    -Added mounting holes for display
    -Fixed Switch 19 being .05in out of place
    [Board_Assembly.SLDASM, Display.SLDPRT, Mainboard.brd, Top_Cover.SLDPRT, Top_Cover.STL]
